PrincetonUniversity/data-center-monitoring/README.md

# A Wired Sensing Suite for Data Center Climate Monitoring

This repository contains all files related to the data center climate sensing/monitoring project built as independent work under Prof. David Wentzlaff <<wentzlaf@princeton.edu>>.

Work on this project was conducted by:

 - [Ryan O'Shea '16](http://ryanoshea.com) <<roshea@princeton.edu>> (2015-16)
 - Felix Madutsa '18 <<fmadutsa@princeton.edu>> (2015)
 - Peter de Groot '15
 - Rahul Subramanian '14
 
**For a full breakdown of the project, see the [report](/report-roshea/O'Shea_Ryan_Thesis.pdf).**
