PrincetonUniversity/data-center-monitoring/dcsense-board/3.1-ryanoshea-final-miniaturized-version/V3_design_pkg1/readme.txt

Files included in this design package:

Bottom Soldermask (V3.GBS) is  on purpose. Please cover the
bottom of the board with soldermask.

├───bom
│       bom.xlsx - parts list mapped to reference designators
│
├───gerber
│       V3.dri
│       V3.GBL - bottom copper
│       V3.GBS - bottom soldermask
|       V3.GKO - board outline
│       V3.gpi
│       V3.GTL - top copper
│       V3.GTO - top silkscreen
│       V3.GTP - top paste
│       V3.GTS - top soldermask
│       V3.TXT - drill file
│
└───pick_place
        V3.mnb - bottom pick-place (empty)
        V3.mnt - top pick-place file with ref. des.
