PrincetonUniversity/data-center-monitoring/dcsense-board/3.1-ryanoshea-final-miniaturized-version/V3_design_pkg0/readme.txt

Files included in this design package:

├───bom
│       bom.xlsx - parts list mapped to reference designators
│
├───gerber
│       V3.dri
│       V3.GBL - bottom copper
│       V3.gpi
│       V3.GTL - top copper & board outline
│       V3.GTO - top silkscreen
│       V3.GTP - top paste
│       V3.GTS - top soldermask
│       V3.TXT - drill file
│
└───pick_place
        V3.mnb - bottom pick-place (empty)
        V3.mnt - top pick-place file with ref. des.
