PrincetonUniversity/data-center-monitoring/dcsense-board/3.1-ryanoshea-final-miniaturized-version/board-size-comparison.png

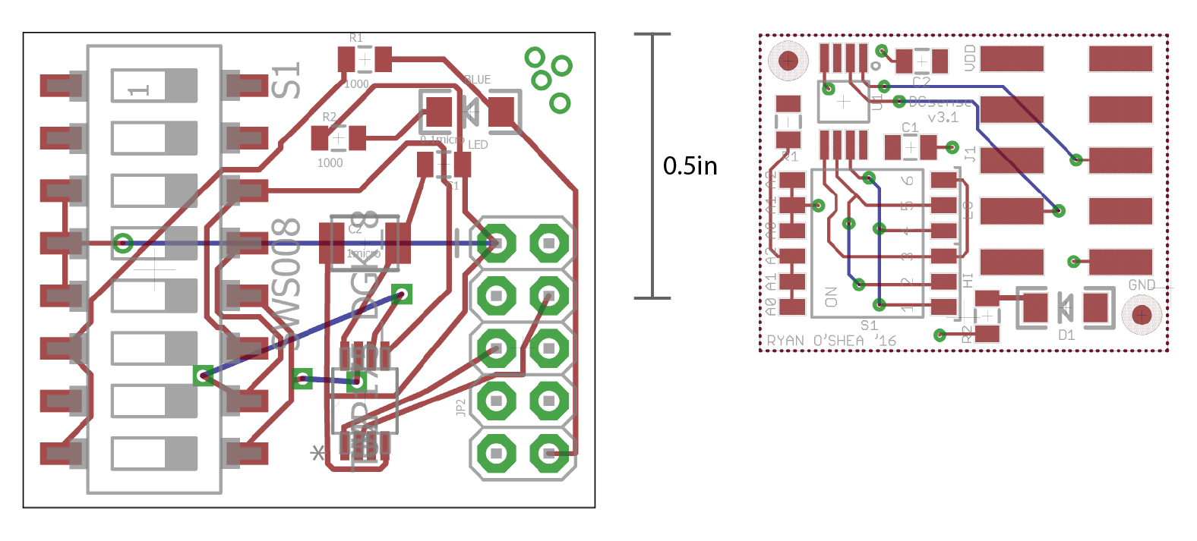
dcsense-board/3.1-ryanoshea-final-miniaturized-version/board-size-comparison.png
