PrincetonUniversity/data-center-monitoring/dcsense-board/3.1-ryanoshea-final-miniaturized-version/V3_brd_filled_plus_preview_2up.png

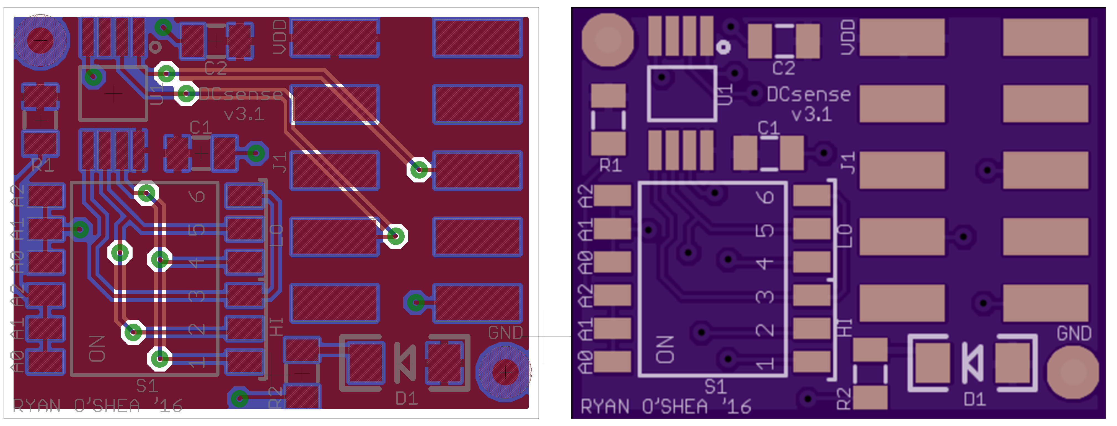
dcsense-board/3.1-ryanoshea-final-miniaturized-version/V3_brd_filled_plus_preview_2up.png
