PrincetonUniversity/data-center-monitoring/dcsense-board/3.1-ryanoshea-final-miniaturized-version/V3_brd_preview_top.png

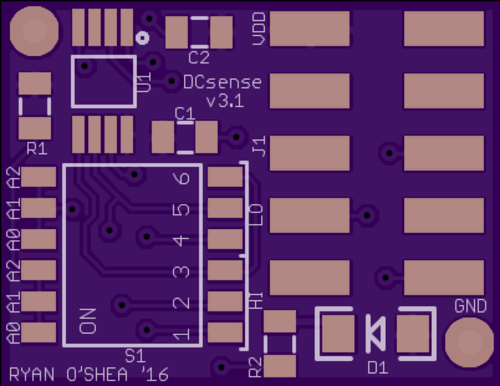
dcsense-board/3.1-ryanoshea-final-miniaturized-version/V3_brd_preview_top.png
