PrincetonUniversity/data-center-monitoring/report-roshea/figures/beaglebone-code-comparison.png

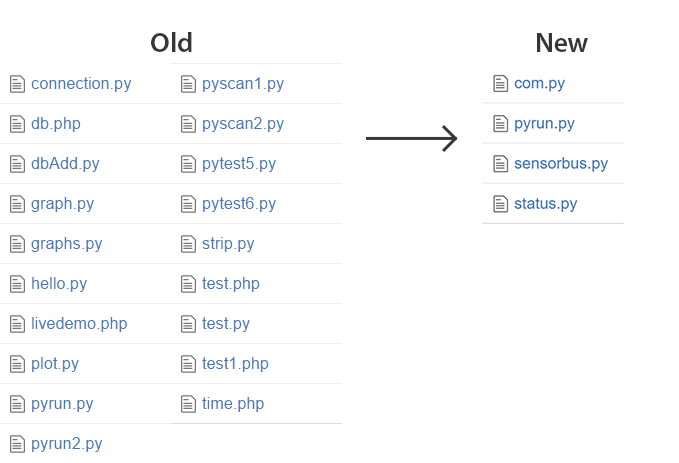
report-roshea/figures/beaglebone-code-comparison.png
