PrincetonUniversity/data-center-monitoring/report-roshea/figures/closed-door.jpg

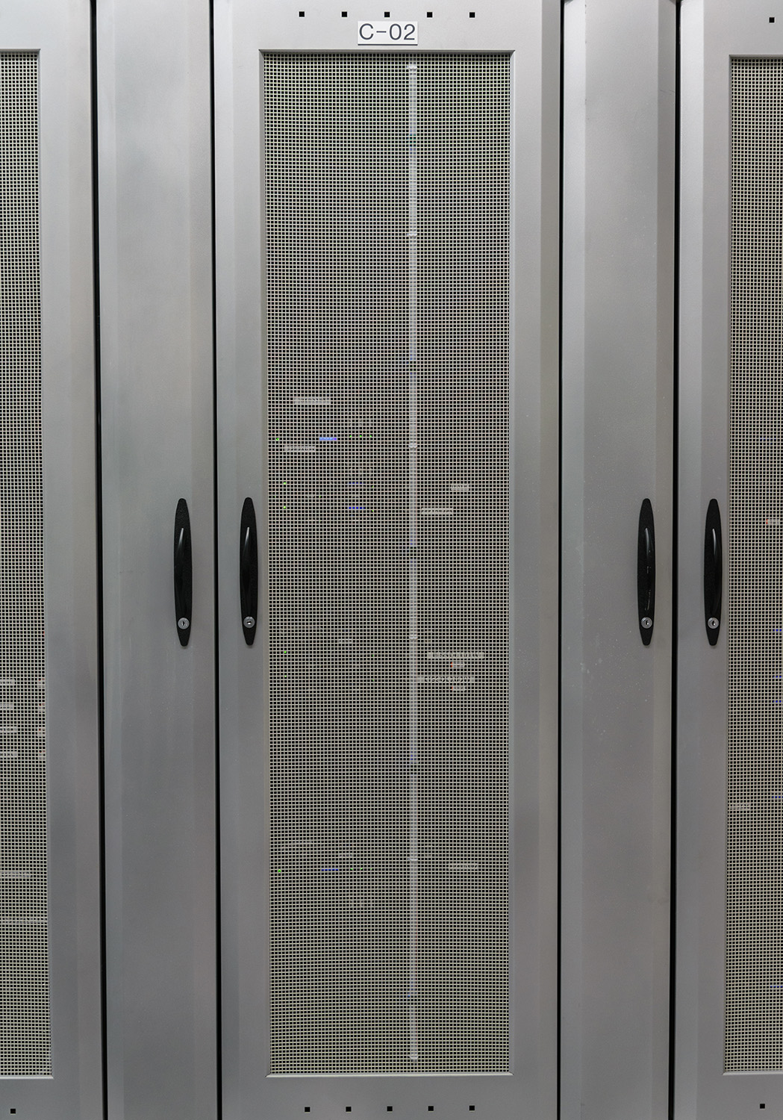
report-roshea/figures/closed-door.jpg
