PrincetonUniversity/data-center-monitoring/report-roshea/figures/codebase-new.png

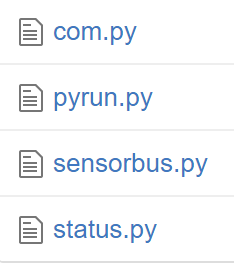
report-roshea/figures/codebase-new.png
