PrincetonUniversity/data-center-monitoring/report-roshea/figures/dcsense-board-angle.jpg

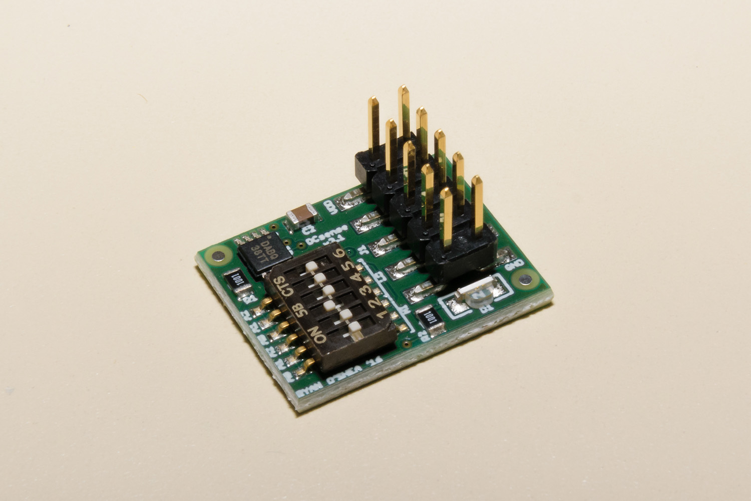
report-roshea/figures/dcsense-board-angle.jpg
