PrincetonUniversity/data-center-monitoring/report-roshea/figures/full-door-down.jpg

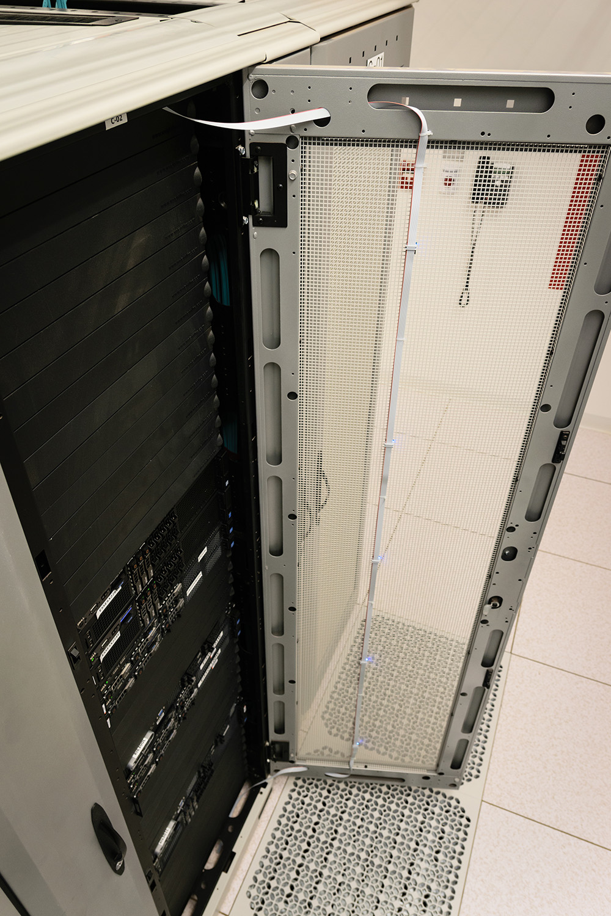
report-roshea/figures/full-door-down.jpg
