PrincetonUniversity/data-center-monitoring/report-roshea/figures/geist-monitor.jpg

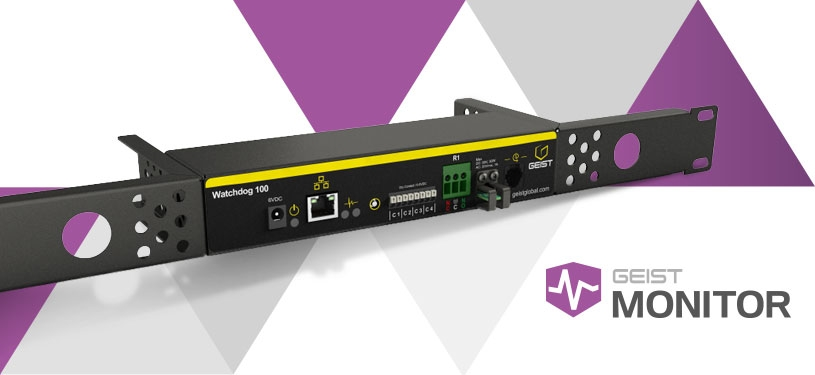
report-roshea/figures/geist-monitor.jpg
