PrincetonUniversity/data-center-monitoring/report-roshea/figures/mounted-beaglebone.jpg

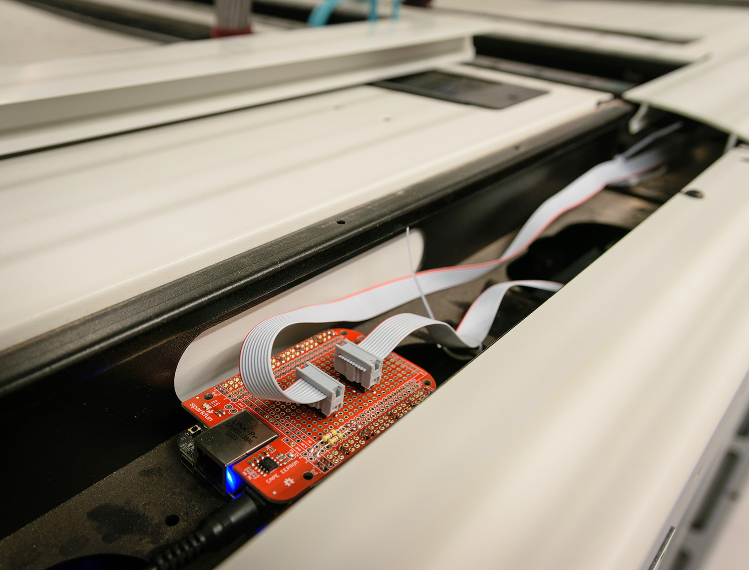
report-roshea/figures/mounted-beaglebone.jpg
