PrincetonUniversity/data-center-monitoring/report-roshea/figures/sensor-on-door.jpg

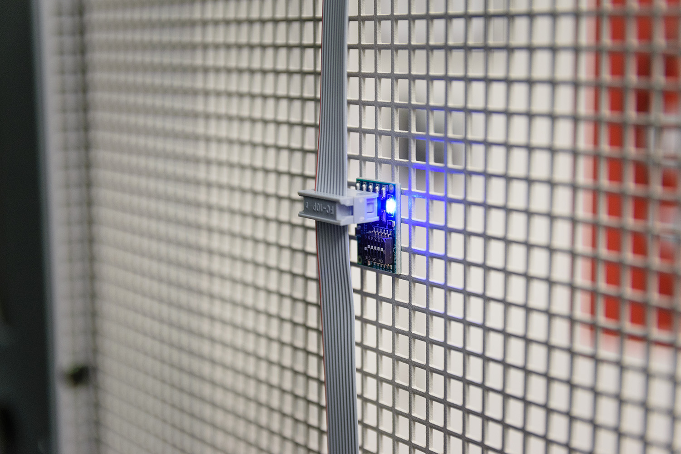
report-roshea/figures/sensor-on-door.jpg
