PrincetonUniversity/data-center-monitoring/report-roshea/figures/sensors-down-door.jpg

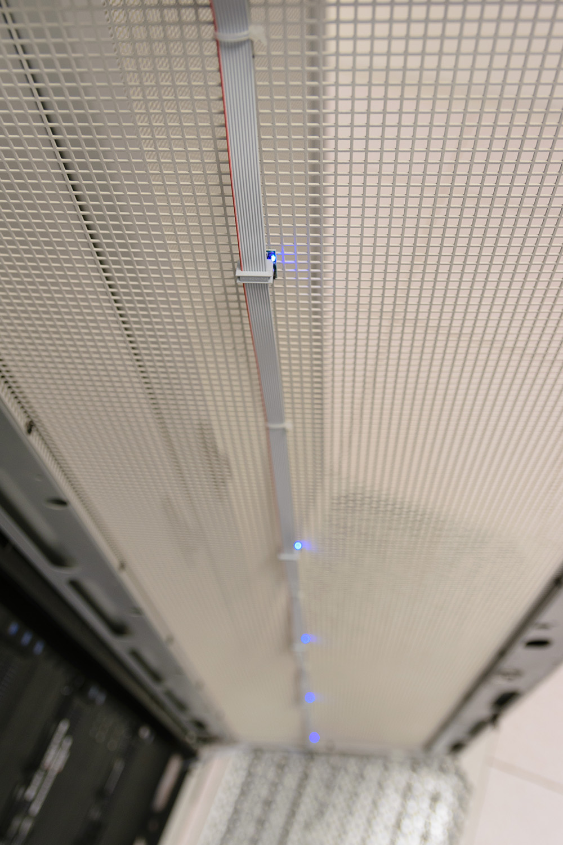
report-roshea/figures/sensors-down-door.jpg
