PrincetonUniversity/data-center-monitoring/report-roshea/figures/sensors-open-cabinet.jpg

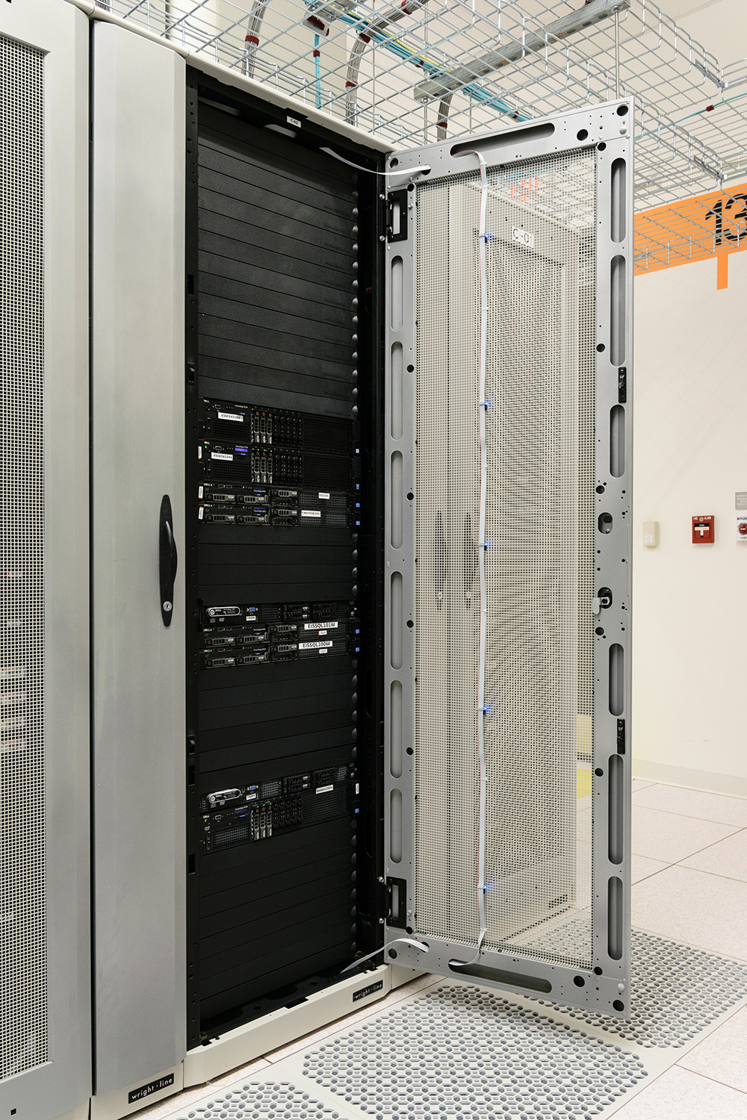
report-roshea/figures/sensors-open-cabinet.jpg
