PrincetonUniversity/data-center-monitoring/report-roshea/figures/webapp/alerts.png

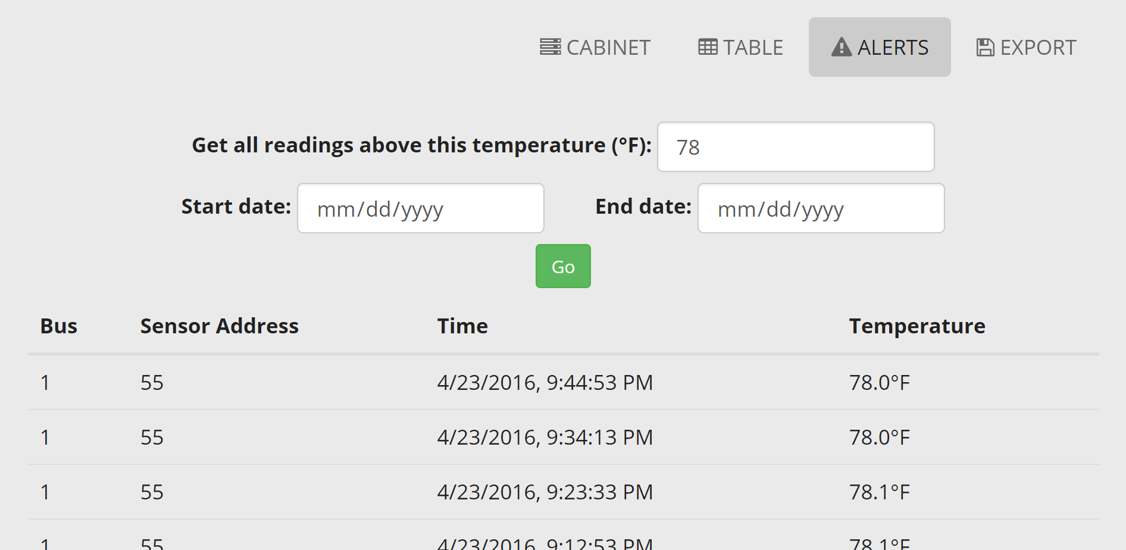
report-roshea/figures/webapp/alerts.png
