PrincetonUniversity/data-center-monitoring/report-roshea/figures/webapp/dash.png

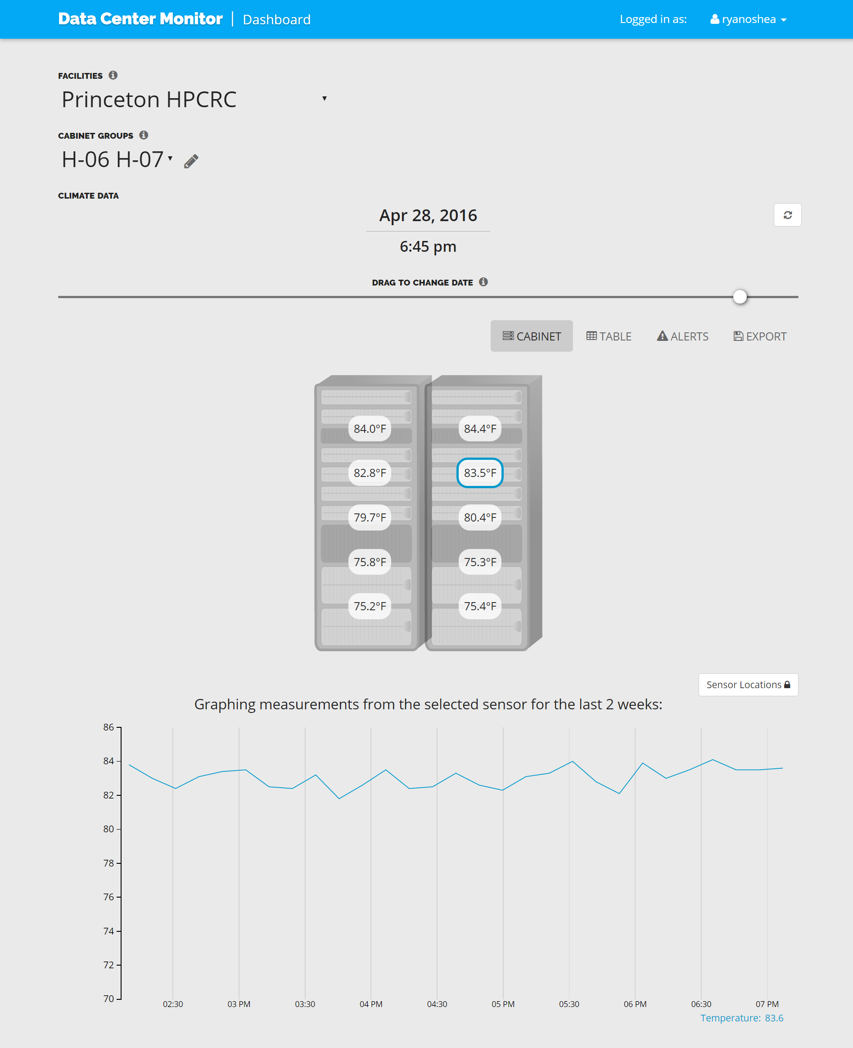
report-roshea/figures/webapp/dash.png
