PrincetonUniversity/data-center-monitoring/report-roshea/figures/webapp/login.png

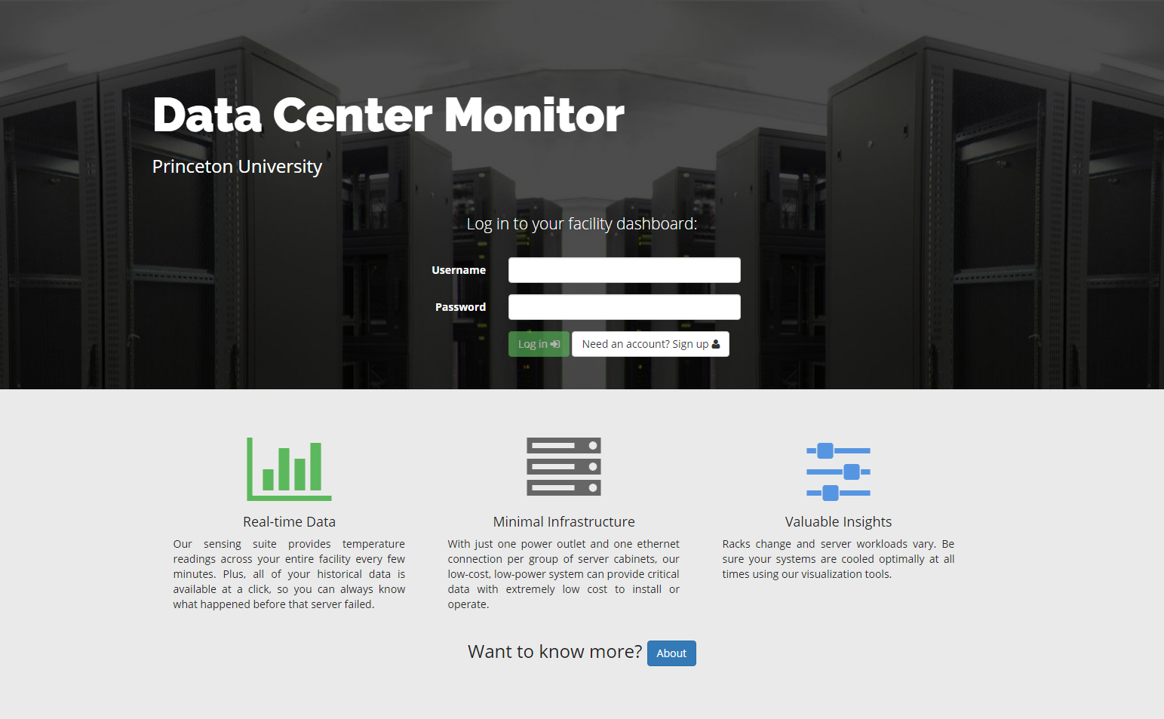
report-roshea/figures/webapp/login.png
