PrincetonUniversity/data-center-monitoring/report-roshea/figures/webapp/mapping-editor.png

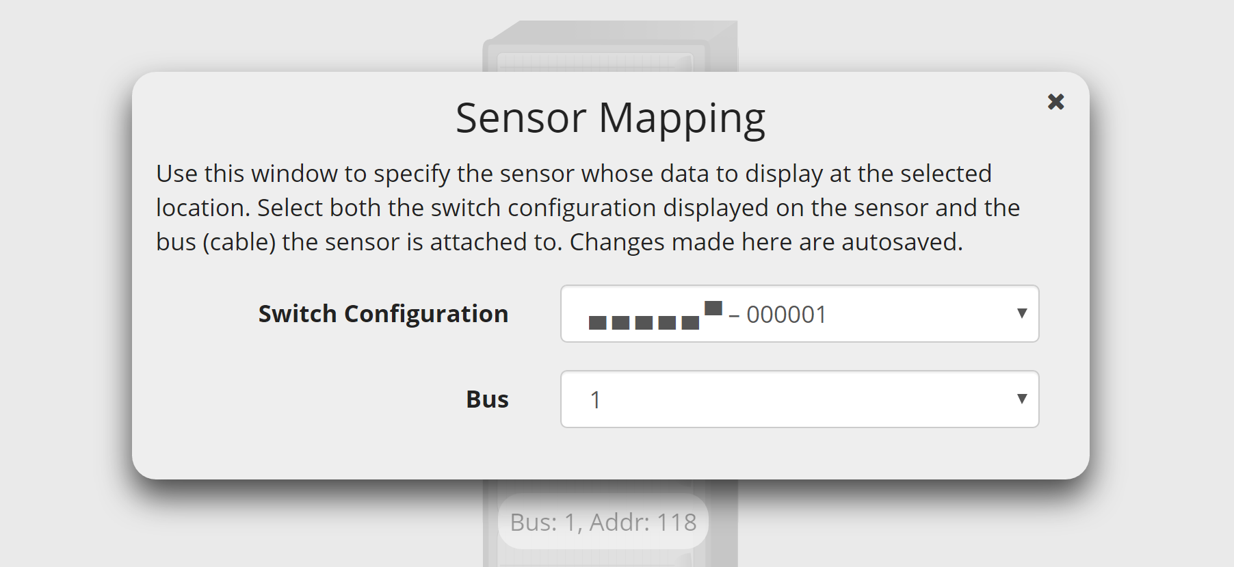
report-roshea/figures/webapp/mapping-editor.png
