PrincetonUniversity/data-center-monitoring/server-app/frontend/img/github.png

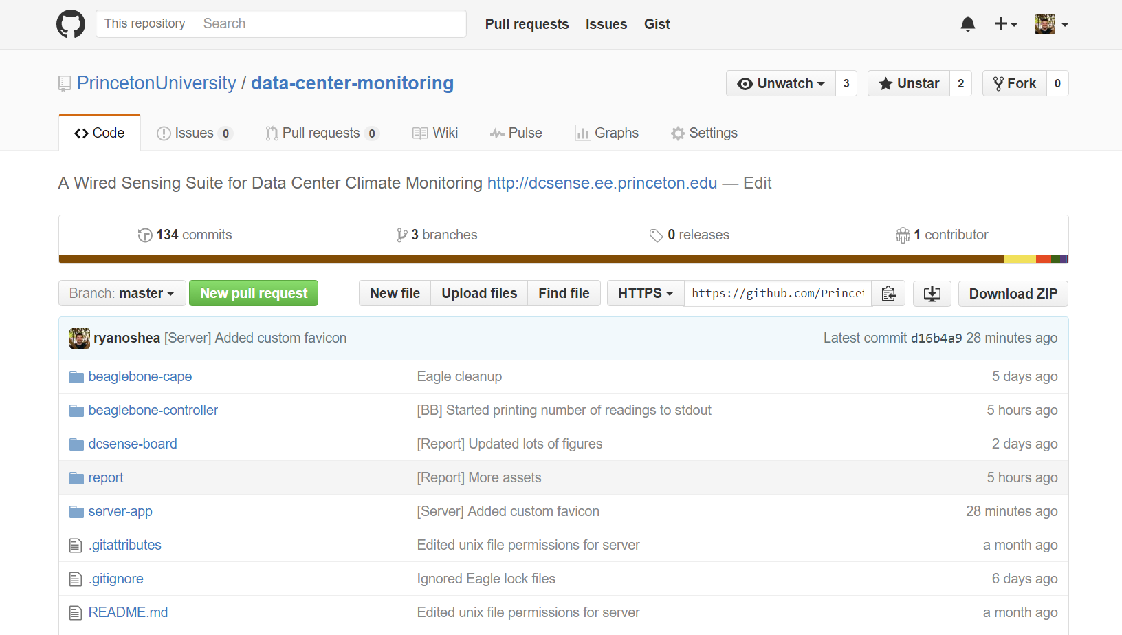
server-app/frontend/img/github.png
