PrincetonUniversity/data-center-monitoring/server-app/frontend/img/system-diagram.png

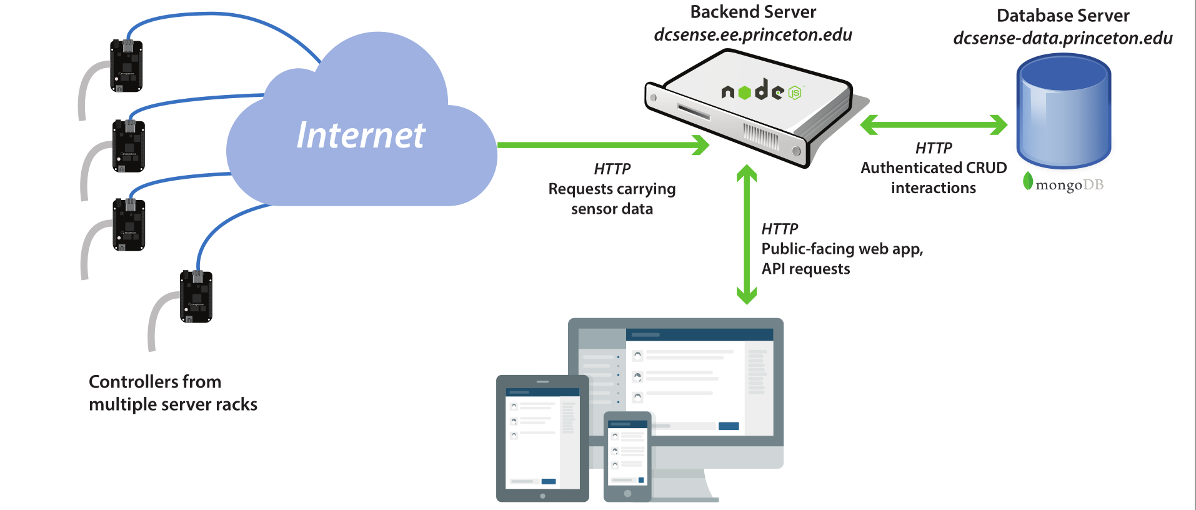
server-app/frontend/img/system-diagram.png
