PrincetonUniversity/data-center-monitoring/server-app/frontend/img/thesis.png

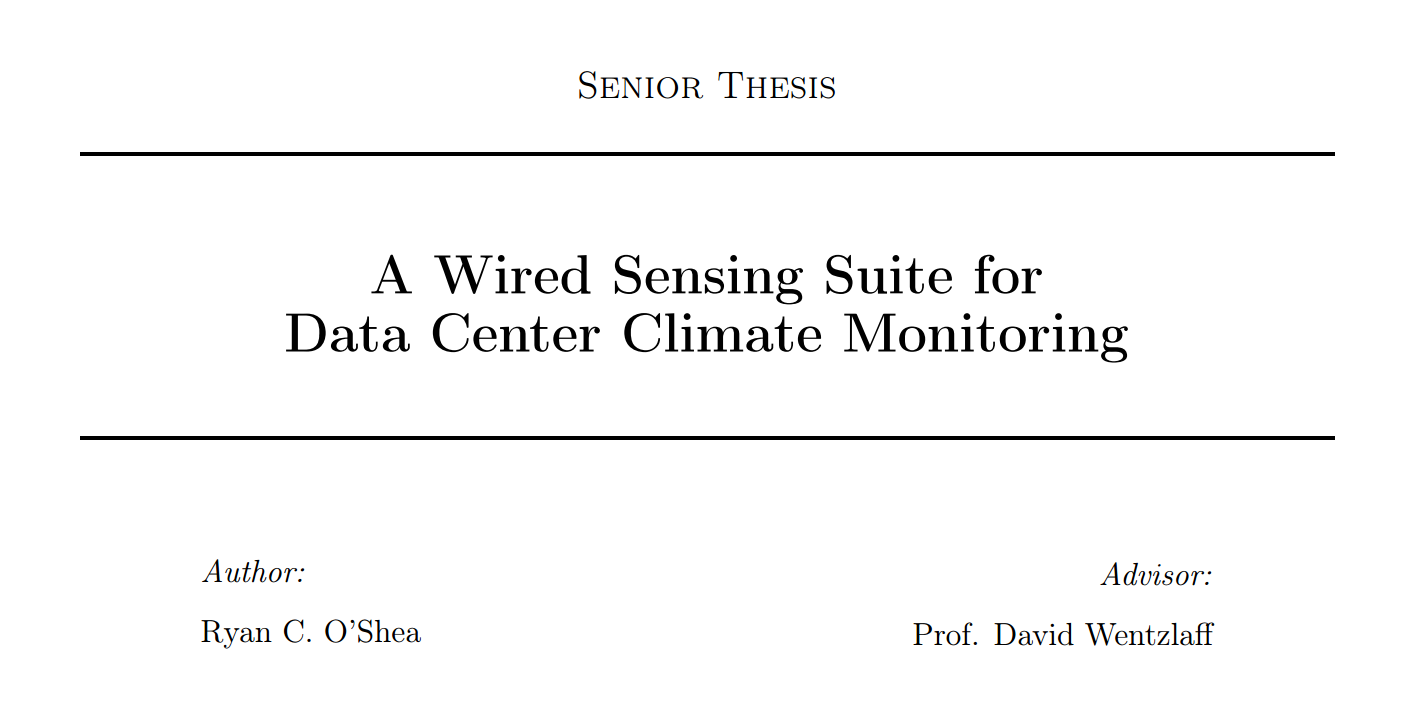
server-app/frontend/img/thesis.png
