PrincetonUniversity/data-center-monitoring/dcsense-board/3.1-ryanoshea-final-miniaturized-version/bom.xlsx

Part |  | Vendor | Vendor Part Num | Manufacturer | Manufacturer Part Num | Price (x50) | Quantity | Total
0.1" 5x2 Headers | https://www.digikey.com/product-detail/en/54202-G0805LF/609-4723-ND/4240461 | Digi-Key | 609-4723-ND | FCI | 54202-G0805LF | 0.68 | 50 | 34
2mm Ribbon Cable Connector | https://www.digikey.com/product-detail/en/TCSD-05-S-06.00-01-N/SAM8870-ND/1106672 | Digi-Key | SAM8870-ND | Samtec | TCSD-05-D-06.00-01-N | 4.86 | 50 | 243
1mm Ribbon Cable (100m) | https://www.digikey.com/product-detail/en/3625%2F10%20100M/MC10L-100-ND/229776 | Digi-Key | MC10L-100-ND | 3M | 3625/10 100M | 73.81 | 1 | 73.81
DIP Switches (0.05") | https://www.digikey.com/product-detail/en/218-6LPST/CT2186LPST-ND/267321 | Digi-Key | CT2186LPST-ND | CTS Electrocomponents | 218-6LPST | 1.273 | 50 | 63.65
15uF 0805 Ceramic Capacitor | https://www.digikey.com/product-detail/en/C2012JB1A156M085AC/445-11407-2-ND/3948643 | Digi-Key | 445-11407-2-ND | TDK Corporation | C2012JB1A156M085AC | 0.1575 | 50 | 7.875
1208 LED | http://www.digikey.com/product-detail/en/5988391117F/350-3028-1-ND/3906503 | Digi-Key | 350-3028-1-ND | Dialight | 5988391117F | 0.203 | 50 | 10.15
1k Ohm 0805 Resistor |  | Digi-Key | 541-1.00KCTR-ND | Vishay Dale | CRCW08051K00FKEA | 0.0075 | 50 | 0.375
0805 ceramic capacitor | http://www.digikey.com/product-detail/en/CL21F104ZBCNNNC/1276-1007-2-ND/3886665 | Digi-Key | 1276-1007-2-ND | Samsung | CL21F104ZBCNNNC | 0.006 | 50 | 0.3
TMP 175 chip: MSOP-8 packaging - MP175AIDGKT | http://www.digikey.com/product-detail/en/TMP175AIDGKT/296-19882-6-ND/1120838 | Digi-Key | 296-19882-6-ND | TI | TMP175AIDGKT | 1.87 | 50 | 93.5
 |  |  |  |  |  |  |  | 526.66
