PrincetonUniversity/data-center-monitoring/dcsense-board/3.1-ryanoshea-final-miniaturized-version/Quotes.xlsx

Sheet: Fab
Vendor | 50 (per) | 50 (total) | 100 (per) | 100 (total) | 500 (per) | 500 (total) | Selected Lead time
Streamline Circuits | $13.00 | $650.00 | $7.00 | $700.00 | $2.25 | $1125.00 | 2 weeks
Advanced Circuits | $9.37 | $468.50 | $4.77 | $477.00 | $1.09 | $545.00 | 2 weeks
Hughes Circuits | $11.35 | $567.50 | $5.76 | $576.00 | $1.29 | $645.00 | 2 weeks
OSH Park | $2.45 | $122.50 | $2.45 | $245.00 | $2.45 | $1225.00 | 2-4 weeks

Sheet: Assembly
Vendor | 50 (per) | 50 (total) | 100 (per) | 100 (total) | 500 (per) | 500 (total) | Selected Lead time
Advanced Circuits | $13.43 | $671.50 | $9.93 | $993.00 | $7.02 | $3510.00 | 3 weeks
Green Circuits |  | $932.95 |  | $1295.00 |  | $3218.00 | 3 weeks

Sheet: Both
Vendor | 50 (total) | 100 (total) | 500 (total) | Selected Lead time
Advanced Circuits | $1140.00 | $1470.00 | $4055.00 | 5 weeks
Advanced Assembly | $1897.03 | $3138.52 | $7727.04 | 25 days
Hughes Circuits | $3501.50 | $4052.00 | $8780.00 | 15 days
Green Circuits | $1682.95 | $2045.00 | $3968.00 | 4 weeks
