PrincetonUniversity/data-center-monitoring/report-roshea/figures/subsystem-diagram.pdf

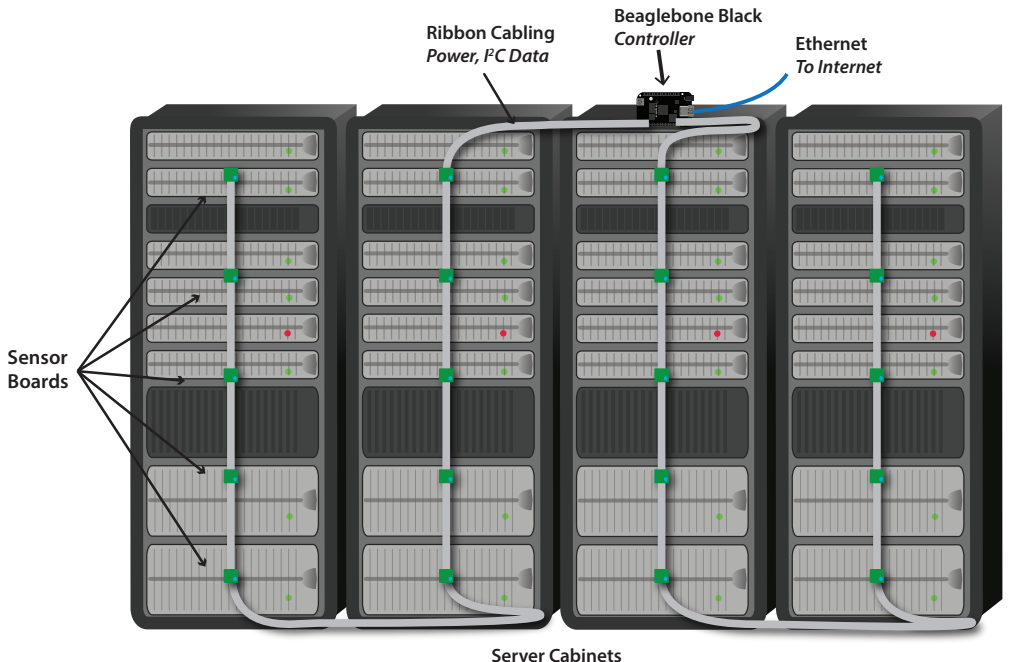
[picture p29: page 1]
beaglebone; Beaglebone Black; Sensor Boards; Ethernet To Internet; Server Cabinets

Controller Ribbon Cabling
C Data
Power, I²
