PrincetonUniversity/data-center-monitoring/report-roshea/plots/dorm-room-temp.pdf

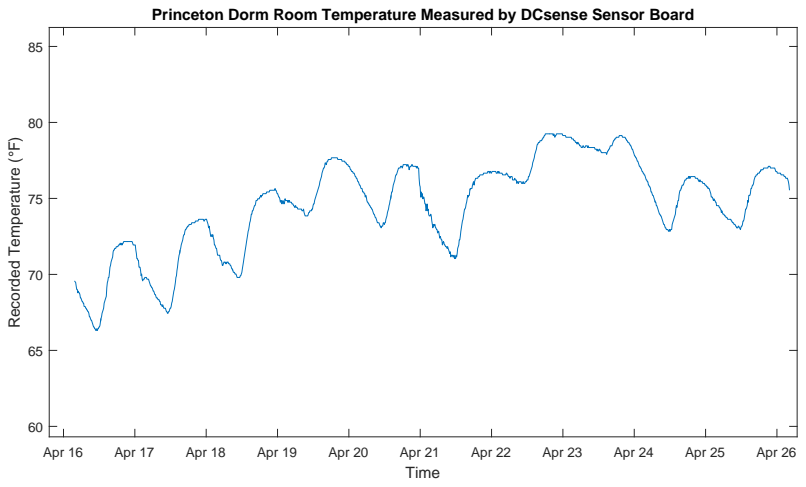
[picture p30: page 1]
Apr 16; Apr 17; Apr 18; Apr 19; Apr 20; Apr 21; Apr 22; Apr 23; Apr 24; Apr 25; Apr 26; Time; Recorded Temperature (°F)

Princeton Dorm Room Temperature Measured by DCsense Sensor Board
