PrincetonUniversity/data-center-monitoring/report-roshea/plots/server-room-temp.pdf

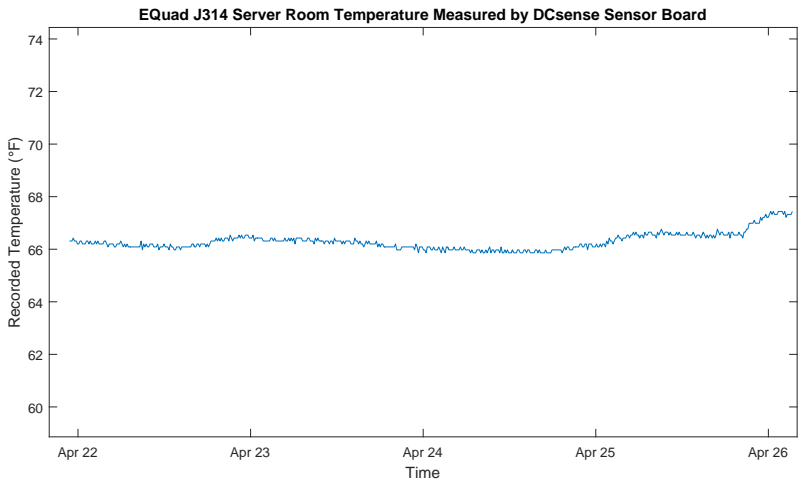
[picture p31: page 1]
Apr 22; Apr 23; Apr 24; Apr 25; Apr 26; Time; Recorded Temperature (°F)

EQuad J314 Server Room Temperature Measured by DCsense Sensor Board
