PrincetonUniversity/data-center-monitoring/report-roshea/figures/system-diagram.pdf

# Internet

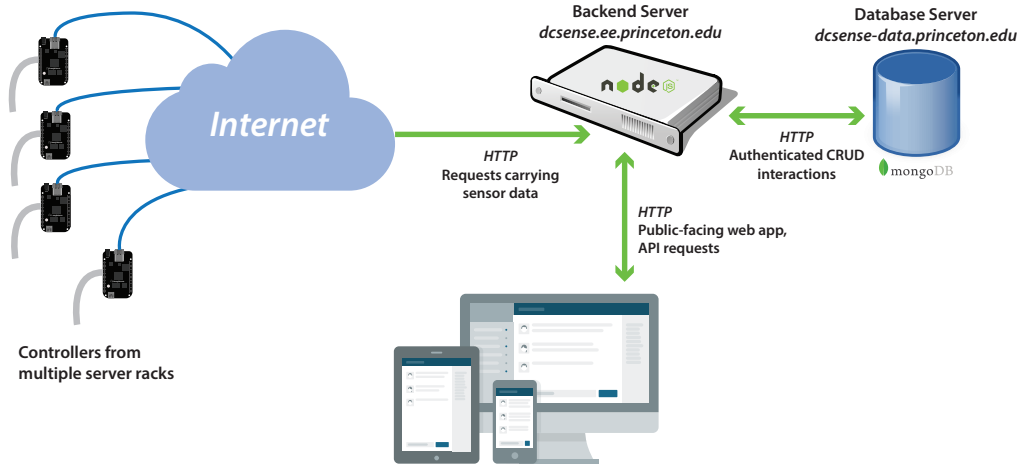
[picture p32: page 1]
beaglebone; HTTP Requests carrying sensor data; HTTP Authenticated CRUD interactions

Backend Server
dcsense.ee.princeton.edu

Database Server
dcsense-data.princeton.edu

HTTP
Public-facing web app,
API requests

Controllers from
multiple server racks
