PrincetonUniversity/data-center-monitoring/dcsense-board/3.1-ryanoshea-final-miniaturized-version/V3_sch.pdf

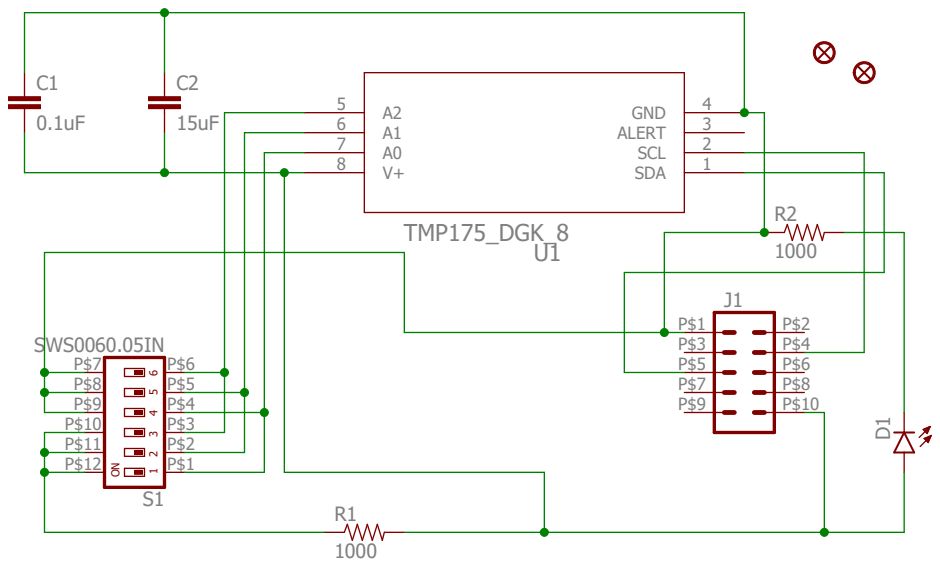
[picture p33: page 1]
SWS0060.05IN; TMP175_DGK_8; SDA; 1 SCL; 2 ALERT; 3 GND
