PrincetonUniversity/data-center-monitoring/dcsense-board/eagle-tools/BBB_Proto_Cape.brd

## EAGLE design dcsense-board/eagle-tools/BBB_Proto_Cape.brd (2016-04-15)

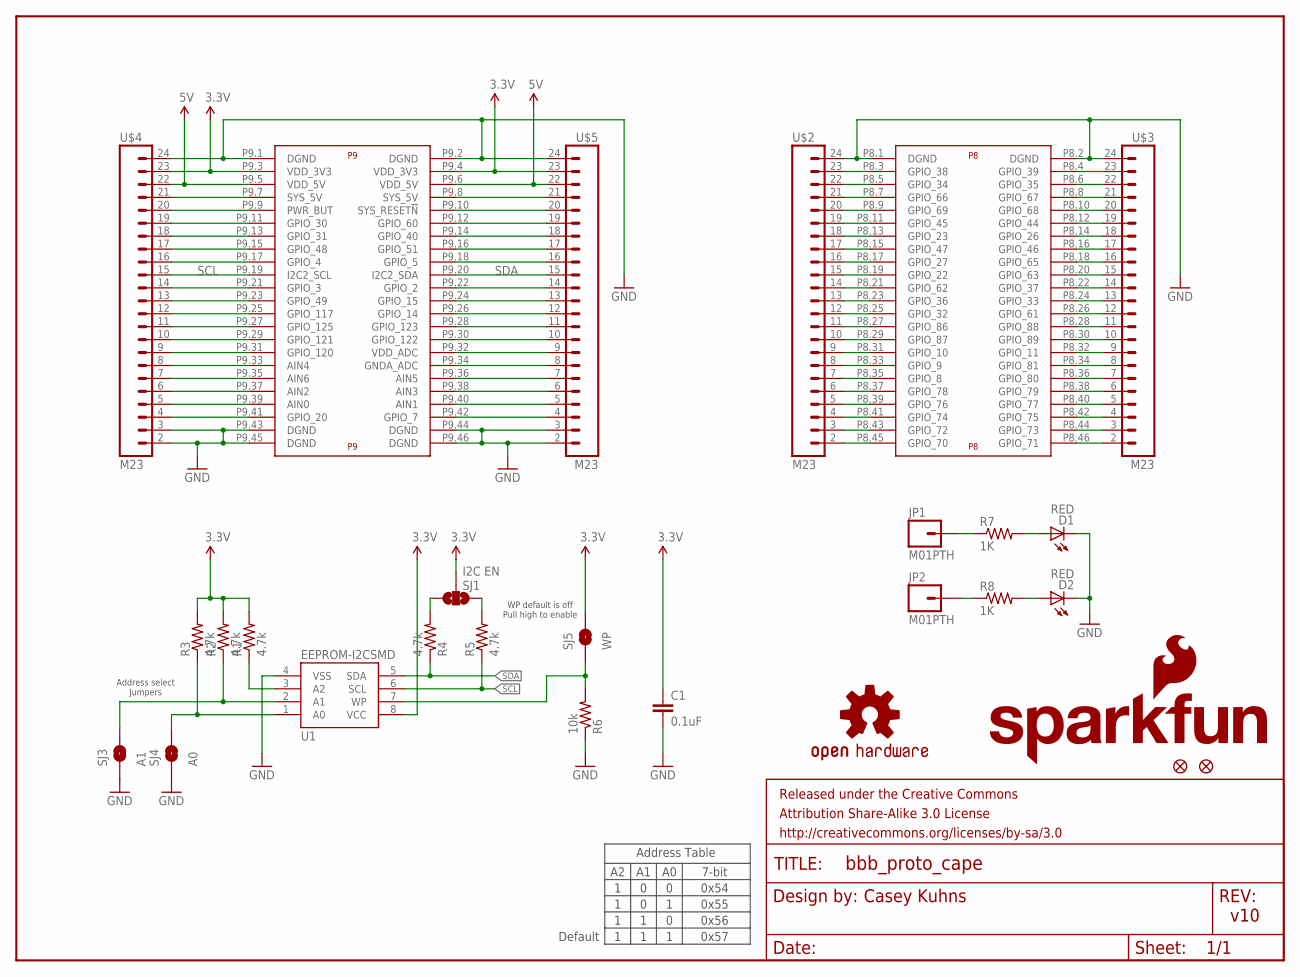
[picture p35: schematic BBB_Proto_Cape.sch]

Parts:
C1: 0.1uF; 0603-CAP
D1, D2: RED; LED-0603
FID1, FID2: FIDUCIAL1X2; FIDUCIAL-1X2
FRAME1: FRAME-LETTER; CREATIVE_COMMONS
JP1, JP2: M01PTH; 1X01
LOGO2: OSHW-LOGOS; OSHW-LOGO-S
LOGO3: SFE_LOGO_NAME_FLAME.1_INCH; SFE_LOGO_NAME_FLAME_.1
R1, R2, R3, R4, R5: 4.7k; 0603
R6: 10k; 0603-RES
R7, R8: 1K; 0603-RES
SJ1: I2C EN; SJ_3_PASTE1&2&3
SJ3: A1; SJ_2S-NO
SJ4: A0; SJ_2S-NO
SJ5: WP; SJ_2S-NO
U1: EEPROM-I2CSMD; SO08
U$1: BEAGLE_BONE_BLACK_CAPE
U$2, U$3, U$4, U$5: M23; 1X23

Connections:
3.3V: C1.1, R1.2, R2.2, R3.2, SJ1.2, SJ5.2, U1.8 (VCC), U$1.P9.3 (VDD_3V3), U$1.P9.4 (VDD_3V3), U$4.23, U$5.23
5V: U$1.P9.5 (VDD_5V), U$1.P9.6 (VDD_5V), U$4.22, U$5.22
A0: R3.1, SJ4.2, U1.1 (A0)
A1: R2.1, SJ3.2, U1.2 (A1)
GND: C1.2, D1.C, D2.C, R6.1, SJ3.1, SJ4.1, U1.4 (VSS), U$1.P8.1 (DGND), U$1.P8.2 (DGND), U$1.P9.1 (DGND), U$1.P9.2 (DGND), U$1.P9.43 (DGND), U$1.P9.44 (DGND), U$1.P9.45 (DGND), U$1.P9.46 (DGND), U$2.24, U$3.24, U$4.2, U$4.3, U$4.24, U$5.2, U$5.3, U$5.24
unnamed: R6.2, SJ5.1, U1.7 (WP)
unnamed: U$1.P8.45 (GPIO_70), U$2.2
unnamed: D1.A, R7.2
unnamed: U$1.P8.43 (GPIO_72), U$2.3
unnamed: U$1.P8.41 (GPIO_74), U$2.4
unnamed: R1.1, U1.3 (A2)
unnamed: D2.A, R8.2
unnamed: JP1.1, R7.1
unnamed: U$1.P8.39 (GPIO_76), U$2.5
unnamed: R4.2, SJ1.3
unnamed: R5.2, SJ1.1
unnamed: U$1.P8.37 (GPIO_78), U$2.6
unnamed: U$1.P8.35 (GPIO_8), U$2.7
unnamed: U$1.P8.33 (GPIO_9), U$2.8
unnamed: U$1.P8.31 (GPIO_10), U$2.9
unnamed: U$1.P8.29 (GPIO_87), U$2.10
unnamed: U$1.P8.27 (GPIO_86), U$2.11
unnamed: U$1.P8.25 (GPIO_32), U$2.12
unnamed: U$1.P8.23 (GPIO_36), U$2.13
unnamed: U$1.P8.21 (GPIO_62), U$2.14
unnamed: U$1.P8.19 (GPIO_22), U$2.15
unnamed: U$1.P8.17 (GPIO_27), U$2.16
unnamed: U$1.P8.15 (GPIO_47), U$2.17
unnamed: U$1.P8.13 (GPIO_23), U$2.18
unnamed: U$1.P8.11 (GPIO_45), U$2.19
unnamed: U$1.P8.9 (GPIO_69), U$2.20
unnamed: U$1.P8.7 (GPIO_66), U$2.21
unnamed: U$1.P8.5 (GPIO_34), U$2.22
unnamed: U$1.P8.3 (GPIO_38), U$2.23
unnamed: JP2.1, R8.1
unnamed: U$1.P8.46 (GPIO_71), U$3.2
unnamed: U$1.P8.44 (GPIO_73), U$3.3
unnamed: U$1.P8.42 (GPIO_75), U$3.4
unnamed: U$1.P8.40 (GPIO_77), U$3.5
unnamed: U$1.P8.38 (GPIO_79), U$3.6
unnamed: U$1.P8.36 (GPIO_80), U$3.7
unnamed: U$1.P8.34 (GPIO_81), U$3.8
unnamed: U$1.P8.32 (GPIO_11), U$3.9
unnamed: U$1.P8.30 (GPIO_89), U$3.10
unnamed: U$1.P8.28 (GPIO_88), U$3.11
unnamed: U$1.P8.26 (GPIO_61), U$3.12
unnamed: U$1.P8.24 (GPIO_33), U$3.13
unnamed: U$1.P8.22 (GPIO_37), U$3.14
unnamed: U$1.P8.20 (GPIO_63), U$3.15
unnamed: U$1.P8.18 (GPIO_65), U$3.16
unnamed: U$1.P8.16 (GPIO_46), U$3.17
unnamed: U$1.P8.14 (GPIO_26), U$3.18
unnamed: U$1.P8.12 (GPIO_44), U$3.19
unnamed: U$1.P8.10 (GPIO_68), U$3.20
unnamed: U$1.P8.8 (GPIO_67), U$3.21
unnamed: U$1.P8.6 (GPIO_35), U$3.22
unnamed: U$1.P8.4 (GPIO_39), U$3.23
unnamed: U$1.P9.42 (GPIO_7), U$5.4
unnamed: U$1.P9.40 (AIN1), U$5.5
unnamed: U$1.P9.38 (AIN3), U$5.6
unnamed: U$1.P9.36 (AIN5), U$5.7
unnamed: U$1.P9.34 (GNDA_ADC), U$5.8
unnamed: U$1.P9.32 (VDD_ADC), U$5.9
unnamed: U$1.P9.30 (GPIO_122), U$5.10
unnamed: U$1.P9.28 (GPIO_123), U$5.11
unnamed: U$1.P9.26 (GPIO_14), U$5.12
unnamed: U$1.P9.24 (GPIO_15), U$5.13
unnamed: U$1.P9.22 (GPIO_2), U$5.14
unnamed: U$1.P9.18 (GPIO_5), U$5.16
unnamed: U$1.P9.16 (GPIO_51), U$5.17
unnamed: U$1.P9.14 (GPIO_40), U$5.18
unnamed: U$1.P9.12 (GPIO_60), U$5.19
unnamed: U$1.P9.10 (SYS_RESET!N), U$5.20
unnamed: U$1.P9.8 (SYS_5V), U$5.21
unnamed: U$1.P9.41 (GPIO_20), U$4.4
unnamed: U$1.P9.39 (AIN0), U$4.5
unnamed: U$1.P9.37 (AIN2), U$4.6
unnamed: U$1.P9.35 (AIN6), U$4.7
unnamed: U$1.P9.33 (AIN4), U$4.8
unnamed: U$1.P9.31 (GPIO_120), U$4.9
unnamed: U$1.P9.29 (GPIO_121), U$4.10
unnamed: U$1.P9.27 (GPIO_125), U$4.11
unnamed: U$1.P9.25 (GPIO_117), U$4.12
unnamed: U$1.P9.23 (GPIO_49), U$4.13
unnamed: U$1.P9.21 (GPIO_3), U$4.14
unnamed: U$1.P9.17 (GPIO_4), U$4.16
unnamed: U$1.P9.15 (GPIO_48), U$4.17
unnamed: U$1.P9.13 (GPIO_31), U$4.18
unnamed: U$1.P9.11 (GPIO_30), U$4.19
unnamed: U$1.P9.9 (PWR_BUT), U$4.20
unnamed: U$1.P9.7 (SYS_5V), U$4.21
SCL: R5.1, U1.6 (SCL), U$1.P9.19 (I2C2_SCL), U$4.15
SDA: R4.1, U1.5 (SDA), U$1.P9.20 (I2C2_SDA), U$5.15

Notes on the sheet:
Address Table
Default
7-bit
0x54
0x56
0x55
0x57
Casey Kuhns
v10
WP default is off Pull high to enable
Address select Jumpers

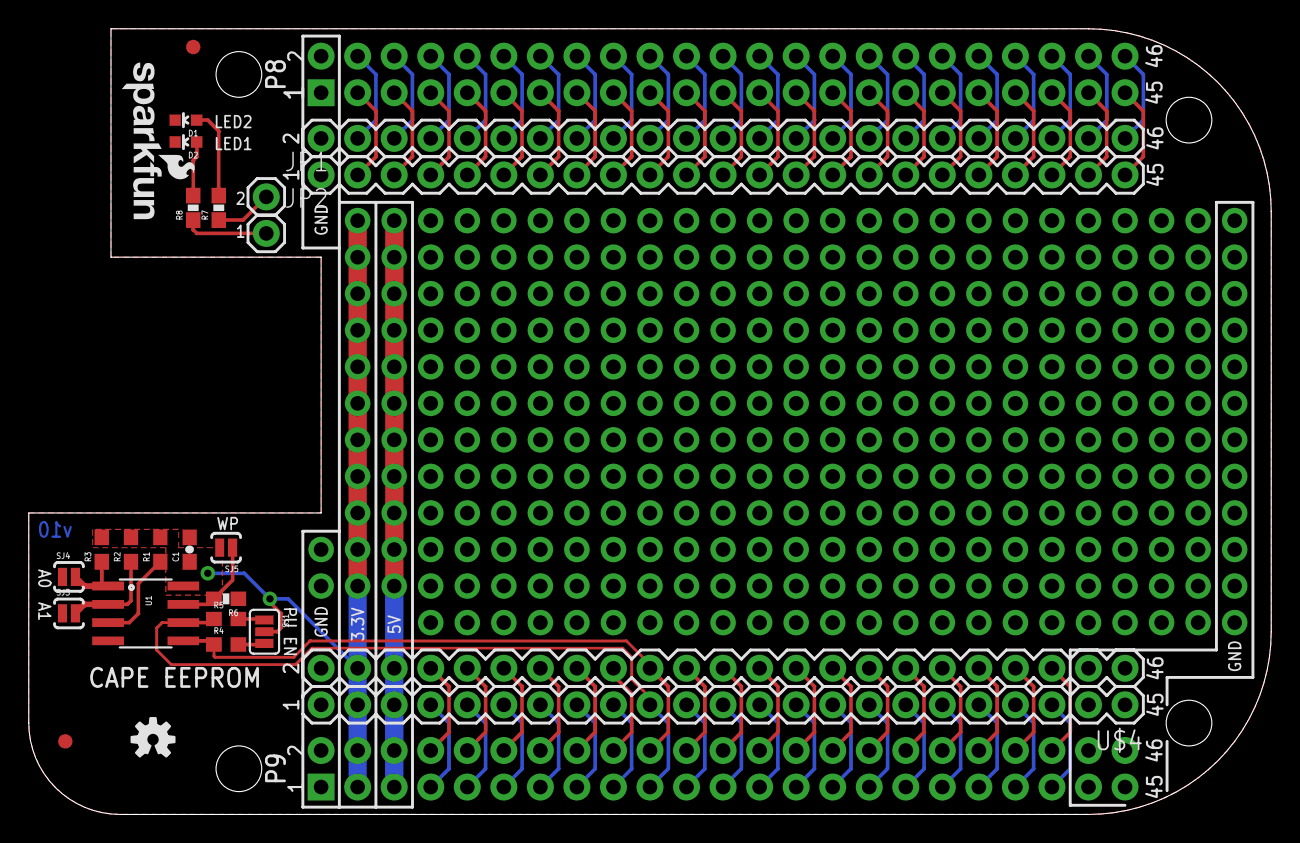
[picture p36: board BBB_Proto_Cape.brd from above]

Board: 2 copper layers, 86.4 x 54.6 mm, 29 parts (1 on the bottom side), 93 nets.

Other parts of the board:
U$6: SFE_LOGO_NAME_FLAME_.1
