PrincetonUniversity/data-center-monitoring/dcsense-board/3.1-ryanoshea-final-miniaturized-version/V3.brd

## EAGLE design dcsense-board/3.1-ryanoshea-final-miniaturized-version/V3.brd (2016-03-07)

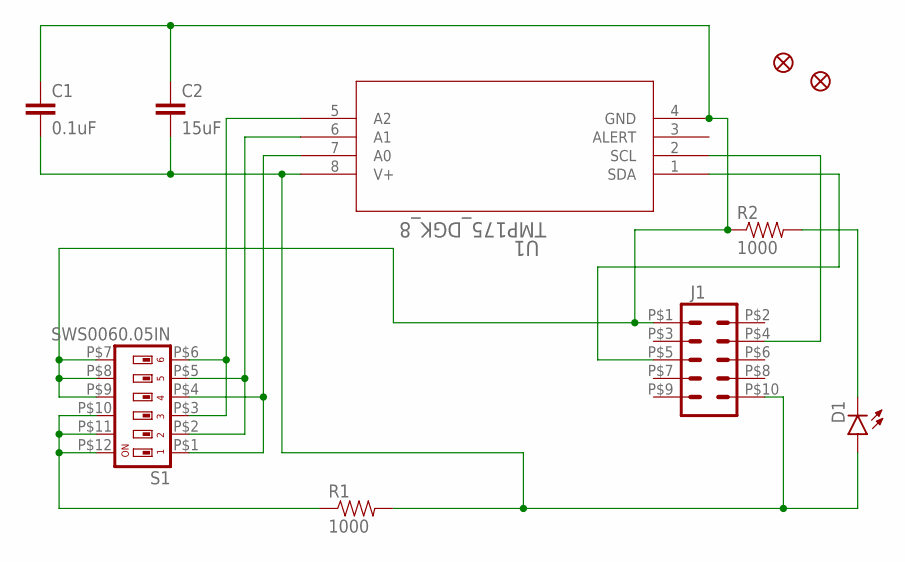
[picture p37: schematic V3.sch]

Parts:
C1: 0.1uF; 0805
C2: 15uF; 0805
D1: LED-BLUE1206; LED-1206
FID1, FID3: FIDUCIAL1X2; FIDUCIAL-1X2
J1: M05X22X5-UNSHROUDED_SMD; 2X5-UNSHROUDED_SMD
R1, R2: 1000; 0805
S1: SWS0060.05IN; SMS-006
U1: TMP175_DGK_8; DGK8

Connections:
A1: S1.P$2 (2), S1.P$5 (5), U1.6 (A1)
A2: S1.P$3 (3), S1.P$6 (6), U1.5 (A2)
GND: C1.1, C2.1, J1.P$1 (1), R2.1, S1.P$7 (7), S1.P$8 (8), S1.P$9 (9), U1.4 (GND)
unnamed: R1.1, S1.P$10 (10), S1.P$11 (11), S1.P$12 (12)
unnamed: S1.P$1 (1), S1.P$4 (4), U1.7 (A0)
unnamed: D1.C, R2.2
POWER: C1.2, C2.2, D1.A, J1.P$10 (10), R1.2, U1.8 (V+)
SCL: J1.P$4 (4), U1.2 (SCL)
SDA: J1.P$5 (5), U1.1 (SDA)

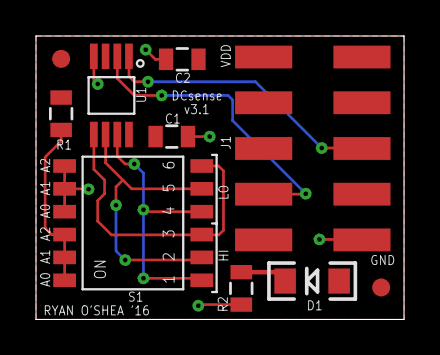
[picture p38: board V3.brd from above]

Board: 2 copper layers, 20.4 x 15.7 mm, 10 parts (0 on the bottom side), 9 nets.
