PrincetonUniversity/data-center-monitoring/dcsense-board/2.0-felix-final-version/BoardSchematic.brd

## EAGLE design dcsense-board/2.0-felix-final-version/BoardSchematic.brd (2016-02-24)

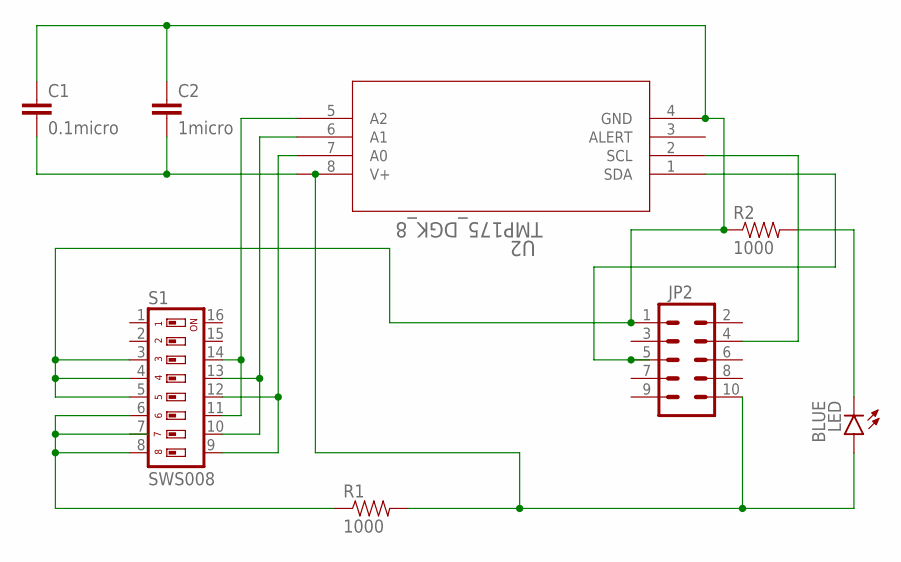
[picture p39: schematic BoardSchematic.sch]

Parts:
C1: 0.1micro; 0805
C2: 1micro; 1210
JP2: M05X2PTH; AVR_ICSP
LED: BLUE; LED-1206
R1, R2: 1000; 0805
S1: SWS008; SMS-008
U2: TMP175_DGK_8; DGK8

Connections:
unnamed: C1.2, C2.2, U2.8 (V+)
unnamed: JP2.4, U2.2 (SCL)
unnamed: C1.1, C2.1, JP2.1, R2.1, S1.3, S1.4, S1.5, U2.4 (GND)
unnamed: R1.1, S1.6, S1.8
unnamed: S1.10, S1.13, U2.6 (A1)
unnamed: S1.9, S1.12, U2.7 (A0)
unnamed: S1.11, S1.14, U2.5 (A2)
unnamed: LED.C, R2.2
unnamed: JP2.10, LED.A, R1.2
unnamed: JP2.5, U2.1 (SDA)

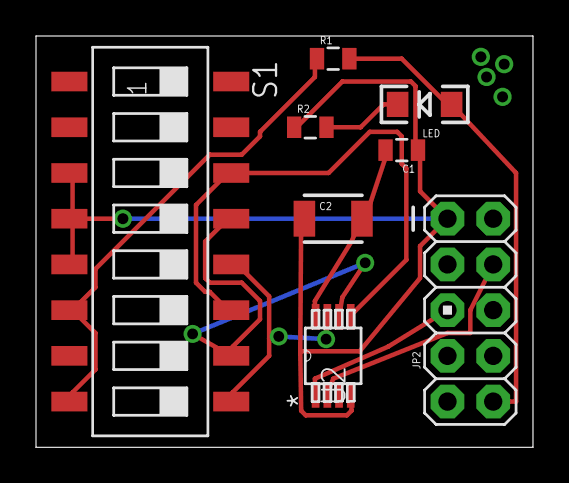
[picture p40: board BoardSchematic.brd from above]

Board: 2 copper layers, 27.6 x 22.8 mm, 8 parts (0 on the bottom side), 10 nets.
