PrincetonUniversity/data-center-monitoring/dcsense-board/3.0-ryanoshea-first-miniaturized-layout/V1/V1.brd

## EAGLE design dcsense-board/3.0-ryanoshea-first-miniaturized-layout/V1/V1.brd (2016-02-24)

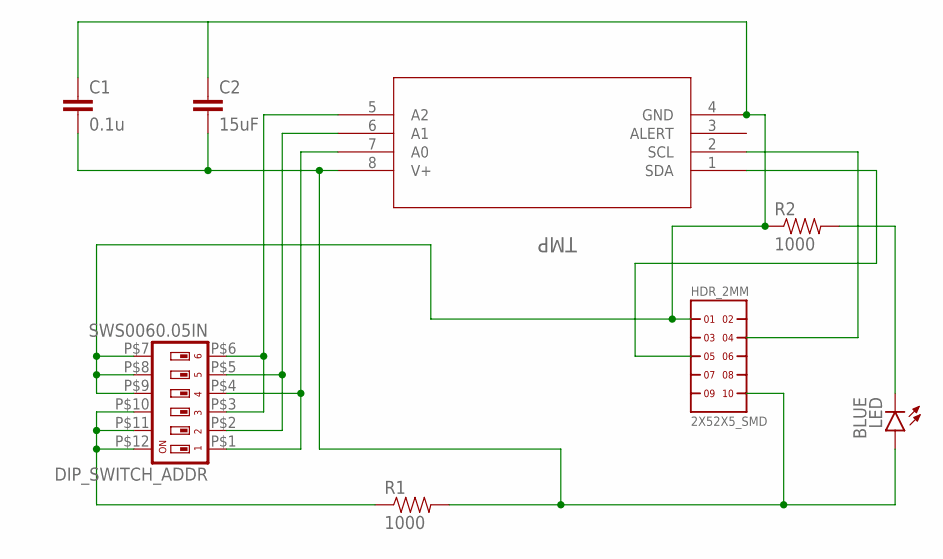
[picture p41: schematic V1.sch]

Parts:
C1: 0.1u; 0805
C2: 15uF; 0805-CAP
DIP_SWITCH_ADDR: SWS0060.05IN; SMS-006
HDR_2MM: 2X52X5_SMD; 2X5
LED: BLUE; LED-1206
R1, R2: 1000; 0805
TMP: TMP175_DGK_8; DGK8

Connections:
A1: DIP_SWITCH_ADDR.P$2 (2), DIP_SWITCH_ADDR.P$5 (5), TMP.6 (A1)
A2: DIP_SWITCH_ADDR.P$3 (3), DIP_SWITCH_ADDR.P$6 (6), TMP.5 (A2)
GND: C1.1, C2.1, DIP_SWITCH_ADDR.P$7 (7), DIP_SWITCH_ADDR.P$8 (8), DIP_SWITCH_ADDR.P$9 (9), HDR_2MM.P$1 (1), R2.1, TMP.4 (GND)
unnamed: C1.2, C2.2, HDR_2MM.P$10 (10), LED.A, R1.2, TMP.8 (V+)
unnamed: DIP_SWITCH_ADDR.P$10 (10), DIP_SWITCH_ADDR.P$11 (11), DIP_SWITCH_ADDR.P$12 (12), R1.1
unnamed: DIP_SWITCH_ADDR.P$1 (1), DIP_SWITCH_ADDR.P$4 (4), TMP.7 (A0)
unnamed: LED.C, R2.2
SCL: HDR_2MM.P$4 (4), TMP.2 (SCL)
SDA: HDR_2MM.P$5 (5), TMP.1 (SDA)

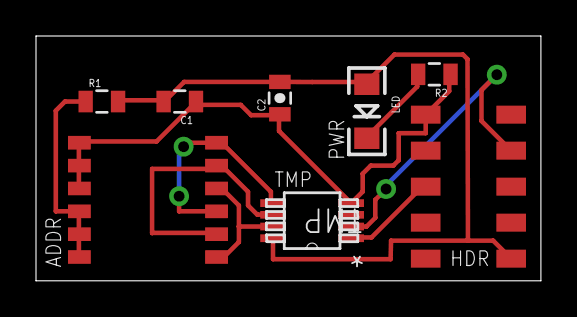
[picture p42: board V1.brd from above]

Board: 2 copper layers, 28.1 x 13.6 mm, 8 parts (0 on the bottom side), 9 nets.
