PrincetonUniversity/data-center-monitoring/beaglebone-cape/beaglebone-cape.sch

## EAGLE design beaglebone-cape/beaglebone-cape.sch (2016-04-27)

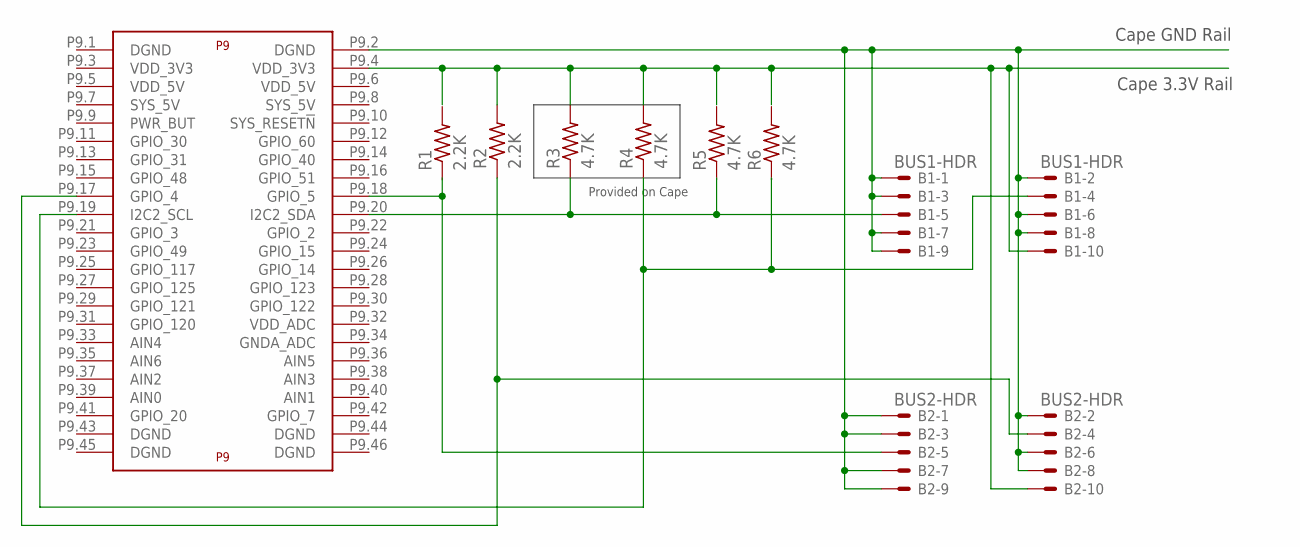
[picture p43: schematic beaglebone-cape.sch]

Parts:
B1: BUS1-HDR; 87758-1016; MPN BUS1-HDR
B2: BUS2-HDR; 87758-1016; MPN BUS2-HDR
R1, R2: 2.2K; 0207/15
R3, R4, R5, R6: 4.7K; 0207/15
U$6: BEAGLE_BONE_BLACK_CAPE

Connections:
GND: B1.1, B1.2, B1.3, B1.6, B1.7, B1.8, B1.9, B2.1, B2.2, B2.3, B2.6, B2.7, B2.8, B2.9, U$6.P9.2 (DGND)
I2C1_SCL: B2.4, R2.1, U$6.P9.17 (GPIO_4)
I2C1_SDA: B2.5, U$6.P9.18 (GPIO_5)
I2C2_SCL: B1.4, R4.1, U$6.P9.19 (I2C2_SCL)
I2C2_SDA: B1.5, R3.1, U$6.P9.20 (I2C2_SDA)
VDD: B1.10, B2.10, R2.2, R3.2, R4.2, U$6.P9.4 (VDD_3V3)

Notes on the sheet:
Cape GND Rail
Cape 3.3V Rail
Provided on Cape
