PrincetonUniversity/data-center-monitoring/beaglebone-controller/connection.py

import mysql.connector
from mysql.connector import Error
 
 
def connect():
    """ Connect to MySQL database """
    try:
        conn = mysql.connector.connect(host='localhost',
                                       database='TempDB',
                                       user='bone',
                                       password='root')
        if conn.is_connected():
            return conn
 
    except Error as e:
        print(e)
        return None
