PrincetonUniversity/data-center-monitoring/beaglebone-controller/graph.py

import matplotlib.pyplot as plt 
import numpy 
import random

z = random(10)
red_dot, = plt.plot(z, "ro", markersize=15)
# Put a white cross over some of the data.
white_cross, = plt.plot(z[:5], "w+", markeredgewidth=3, markersize=15)
plt.legend([red_dot, (red_dot, white_cross)], ["Attr A", "Attr A+B"])
