PrincetonUniversity/data-center-monitoring/(commit log)

2016-02-24 Removed calls to DB, added print statements for temp readings
2016-02-24 Added board files from recent versions
    [Board BoM.xlsx, Board1.brd, Board1.sch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]
2016-03-07 Updated board silkscreens
    [V3.brd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]
2016-03-17 [BB] Added error handling; added data transmission to server
    [com.py, pyrun.py, sensorbus.py, status.py]
2016-03-17 [Server] Added basic server to accept sensor data
2016-03-17 [BB] Fixed bus 2 errors, decreased time resolution
    Also fixed error handling bugs
    [pyrun.py, status.py]
2016-03-18 [BRD] Fixed reference designator for header in BoM
    [bom.xlsx]
2016-03-22 Edited unix file permissions for server
    [Board BoM.xlsx, Board1.brd, Board1.sch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]
2016-03-23 [BB] Added exception handler for failed fork()
    This solution just ignores the error. If it happens frequently, it'll
    need to be addressed a different way to avoid lost readings.
    [com.py]
2016-03-23 [BB] Fixed issue where each bus got different timestamp
    [pyrun.py, sensorbus.py]
2016-03-23 [BB] Fixed issue where child processes became zombies
    [com.py]
2016-03-27 [Server] Added authentication to all requests for sensor data
2016-03-30 [Server] Limited user access to data based on facility ownership
    - Sensor data requests now check for ownership, and requests to list
    facilities return only those a user is owner of (or all if user is
    admin)
    - Added admin tool to link controllers to facilities
    - Added first parts dashboard
2016-04-03 [Sever] Added dcsense board switch-to-address mappings
    [address-map.xlsx]
2016-04-05 [Server] Improved login/signup buttons
2016-04-06 [Server] Cabinets now store sensor layout mapping; frontend now graphically displays those representations
    No tool yet to actually map sensors to particular locations, but
    framework exists for it.
2016-04-09 [Server] Added barebones sensor mapping tool
2016-04-11 [Server] Better sensor mapping editor interface
2016-04-11 [Server] Added basic sensor data graphing
2016-04-11 [Server] Fixed duplicate graphs when switching sensor
2016-04-11 [Sensor] Added selected sensor indicator
2016-04-11 [Server] Added high temperature alert view
2016-04-12 [Server] Sensor mapping editor display bug
2016-04-12 [Server] Hid sensor graph by default, enable hiding graph
2016-04-12 [Server] Added refresh button to dashboard
2016-04-14 [Server] High temperature alerts can now be filtered by date
2016-04-14 [Server] Clicking a sensor in a table displays that sensor in cabinet view
2016-04-15 [BB] Added schematic for BB Cape
    [BBB_Proto_Cape.brd, BBB_Proto_Cape.sch, beaglebone-cape.sch]
2016-04-15 [BB] Added cape schematic image
2016-04-15 [BB] Added readme for BeagleBone cape schematic
2016-04-15 [BB] BeagleBones now send any errors to server
    [com.py, pyrun.py]
2016-04-15 [BB] Improved error logging
    [sensorbus.py, status.py]
2016-04-16 [BB] Fixed syntax error
    [com.py]
2016-04-16 [BB][Server] Fixing errors in readings transmission
    [com.py]
2016-04-16 [Report] Added some board photos
2016-04-16 [BB] Updated cape schematic w/ real resistors
    [beaglebone-cape.sch]
2016-04-17 [BB] Updated sensor board readme
2016-04-17 [BB] Added schematic to sensor board readme
2016-04-17 [BB] bitmap sensor-board schematic
2016-04-21 Revert "[BB] Configured request to go through proxy"
    This reverts commit 49809e4507e91491be8bd2739193c54c67e198bd.
    [com.py]
2016-04-21 [BB] Started printing number of readings to stdout
2016-04-21 [Server] Started timestamping sensor data server-side
2016-04-21 [Server] Spots on server rack without mapped sensors can no longer be clicked
2016-04-22 [Server] Added text explaining sensor graph
2016-04-25 [BB] Fixed some incorrect comments
    [pyrun.py]
2016-04-26 [Report] Created sample plots and updated figures
2016-04-27 [BB] Updated cape schematic
    - All unused wires are now grounded
    - I2C pull-up resistor values decreased
    - Used another pair of 4.7KΩ resistors in parallel with the built-in
    I2C2 pull-ups, making the total pull-up resistance 2.35KΩ
    - Reduced I2C1 pull-ups to the closest available value to 2.35KΩ which
    is, 2.2KΩ
    These changes help with system performance over long bus lengths.
    [beaglebone-cape.sch]
2016-04-27 [Server] Fixed new user registration flow
