PrincetonUniversity/data-center-monitoring/(notices)

Notices in the files:
parts and their libraries:
SparkFun-Boards: Licensing: CC v3.0 Share-Alike You are welcome to use this library for commercial purposes.
SparkFun-Capacitors: Licensing: Creative Commons ShareAlike 4.0 International - https://creativecommons.org/licenses/by-sa/4.0
SparkFun-Aesthetics: Released under the Creative Commons
